DAANHVA/slimme-wekker/docs/img/slimme-wekker.jpg

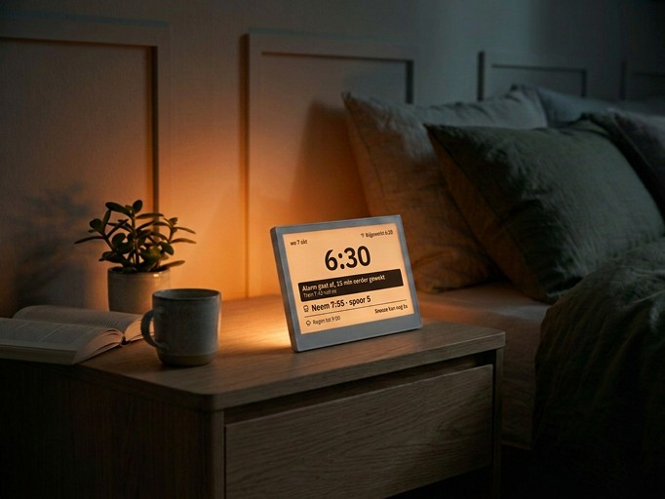
docs/img/slimme-wekker.jpg
