DAANHVA/slimme-wekker/docs/img/scherm.png

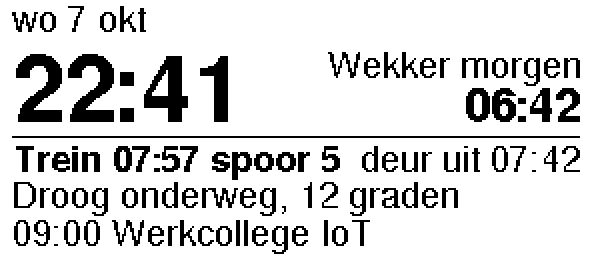
docs/img/scherm.png
